eletroinf/displayzao-clock/docs/display_tos_23101.jpg

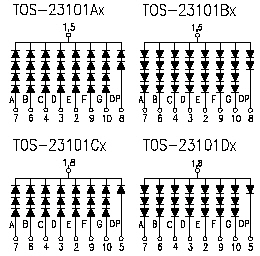
docs/display_tos_23101.jpg
