eletroinf/displayzao-clock/docs/display_tos_23101_.jpg

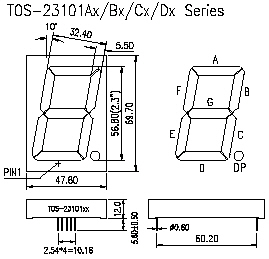
docs/display_tos_23101_.jpg
