eletroinf/displayzao-clock/docs/tos_1106bx.jpg

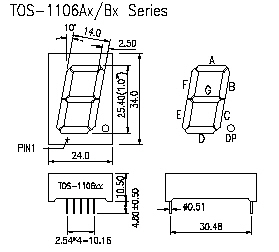
docs/tos_1106bx.jpg
