eletroinf/displayzao-clock/docs/tos_1106bx_.jpg

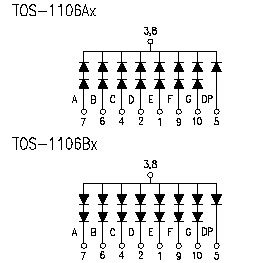
docs/tos_1106bx_.jpg
