eletroinf/displayzao-clock/docs/display_tos_1106.PDF

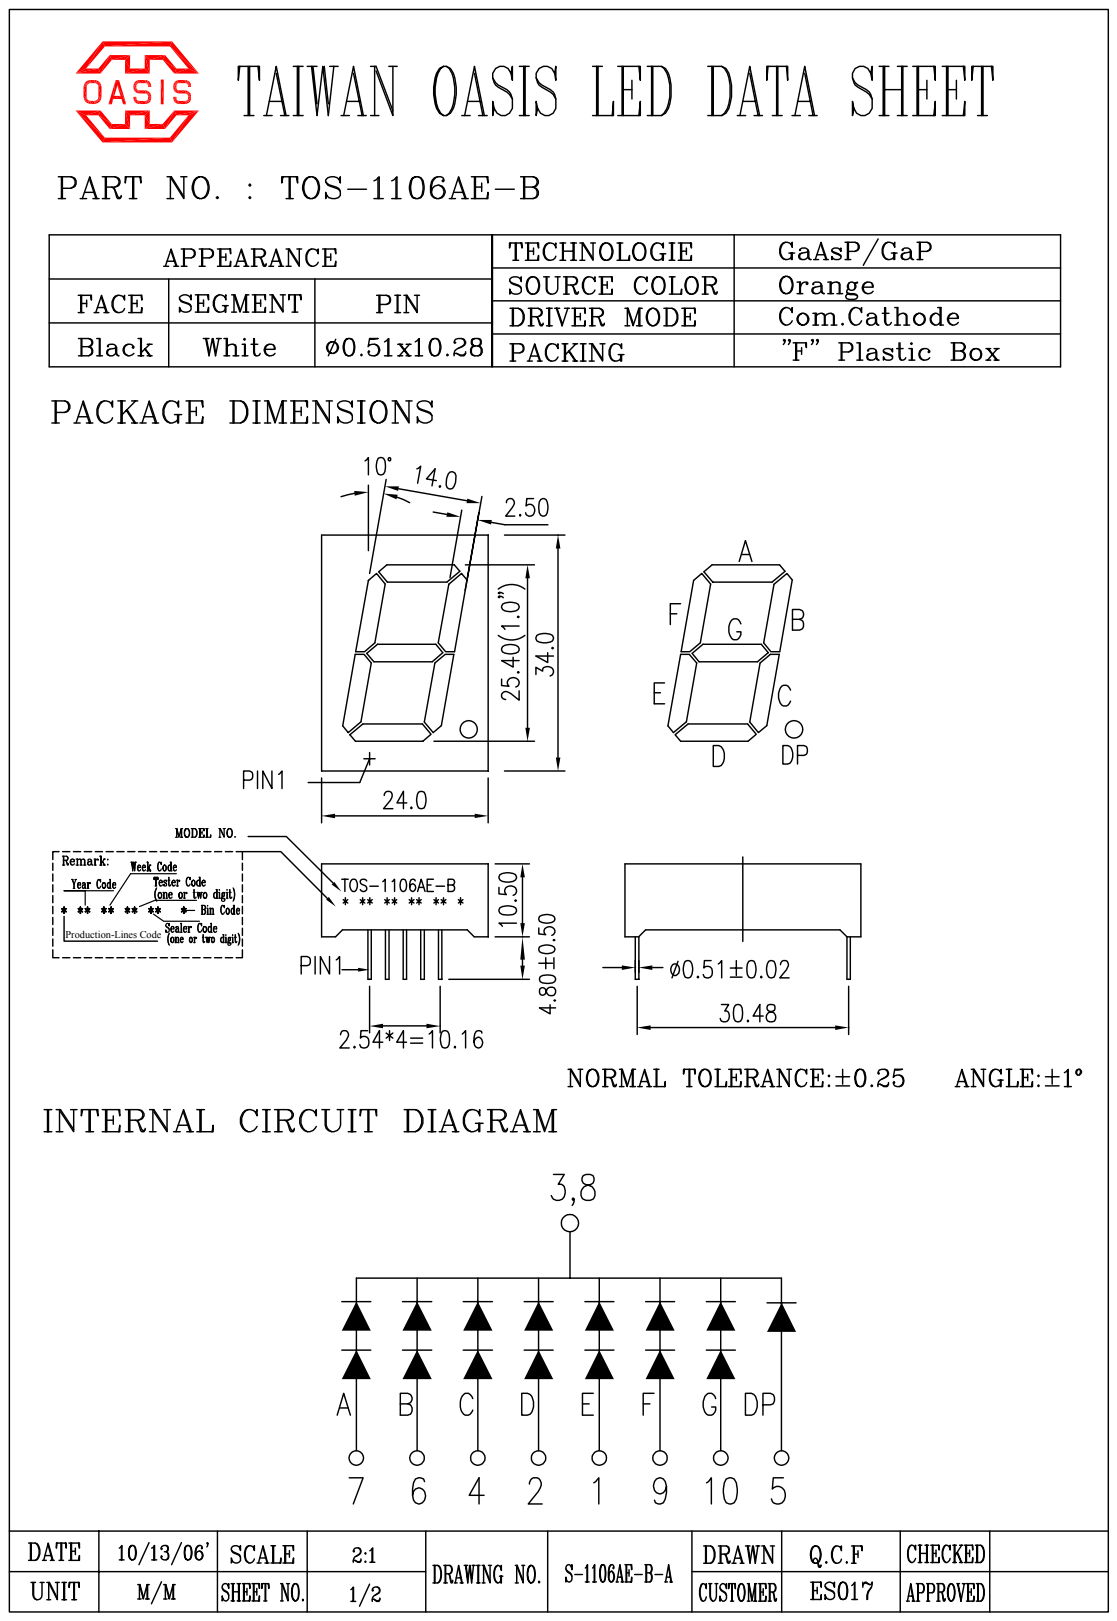
[picture p7: page 1]

Production-Lines Code

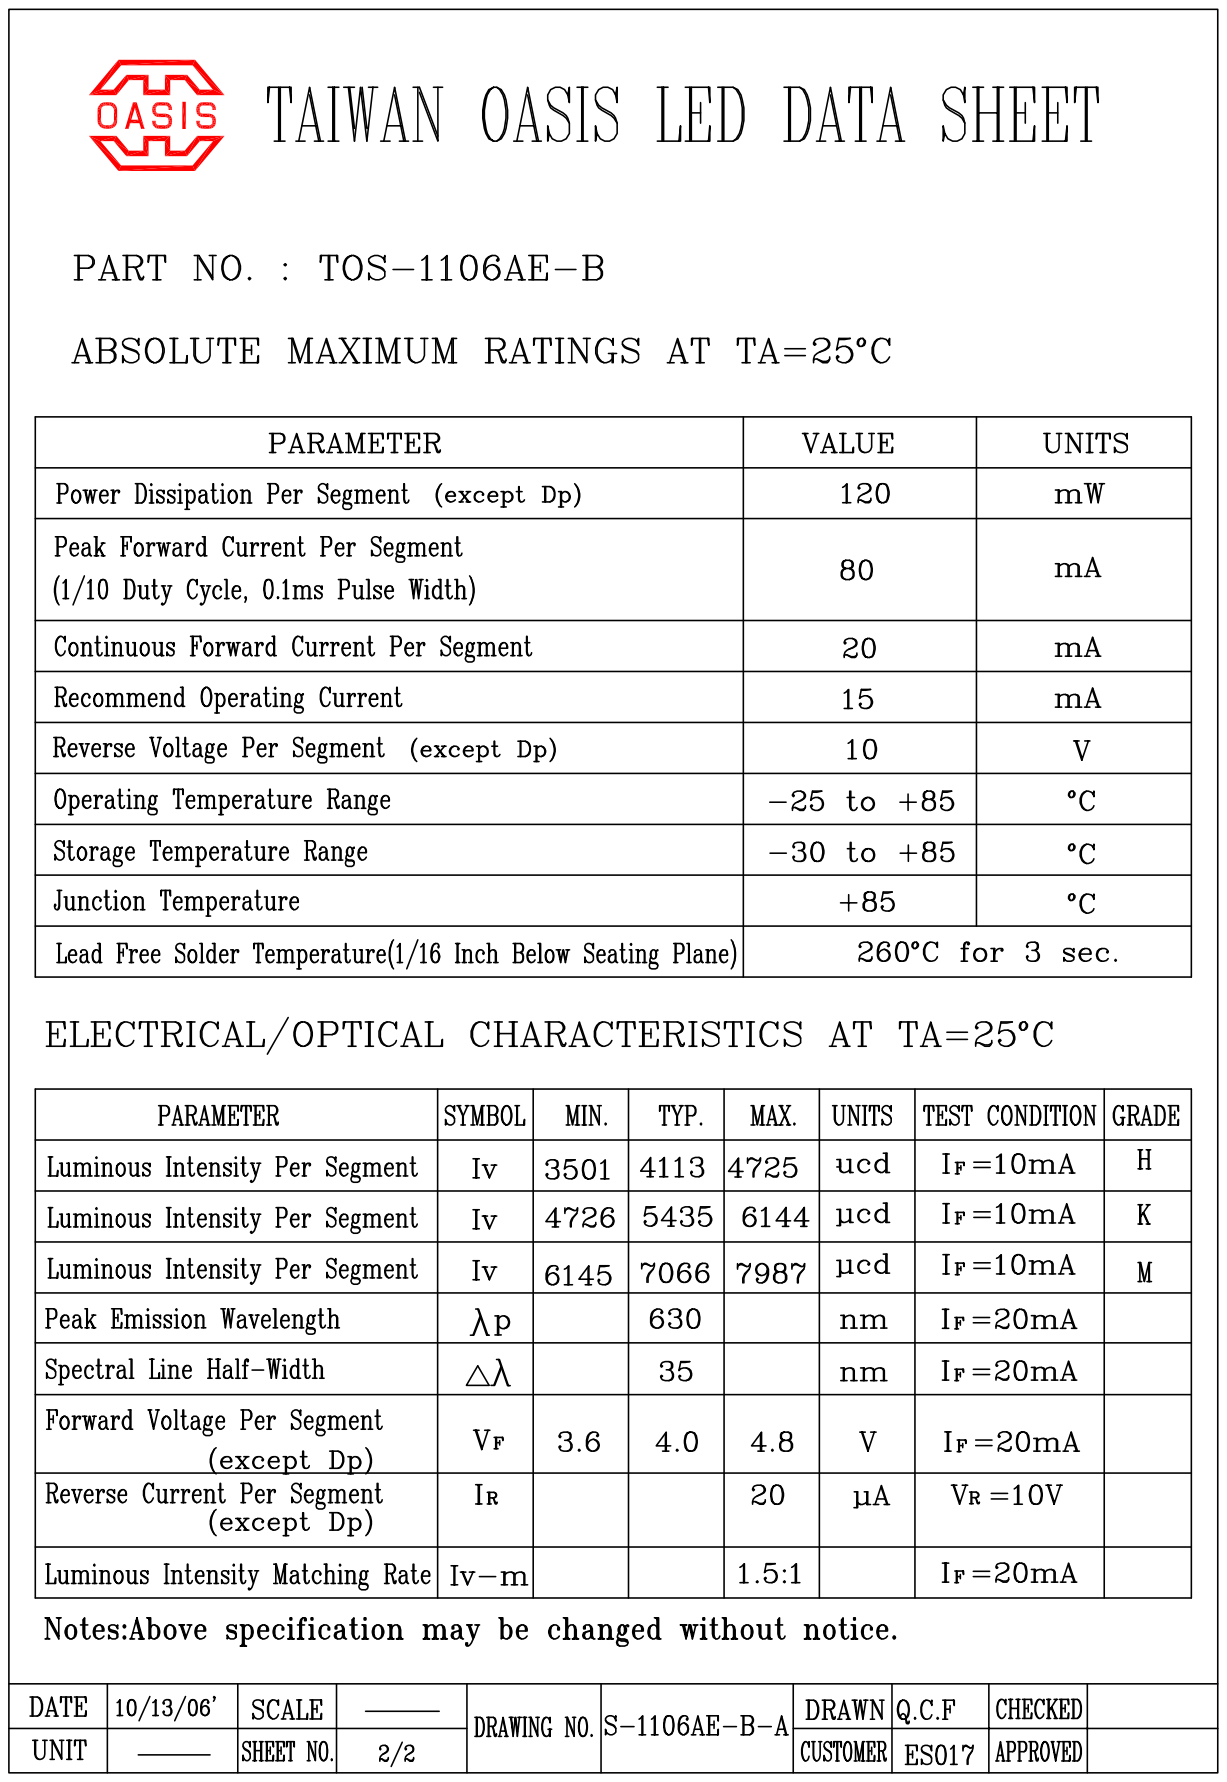
[picture p8: page 2]

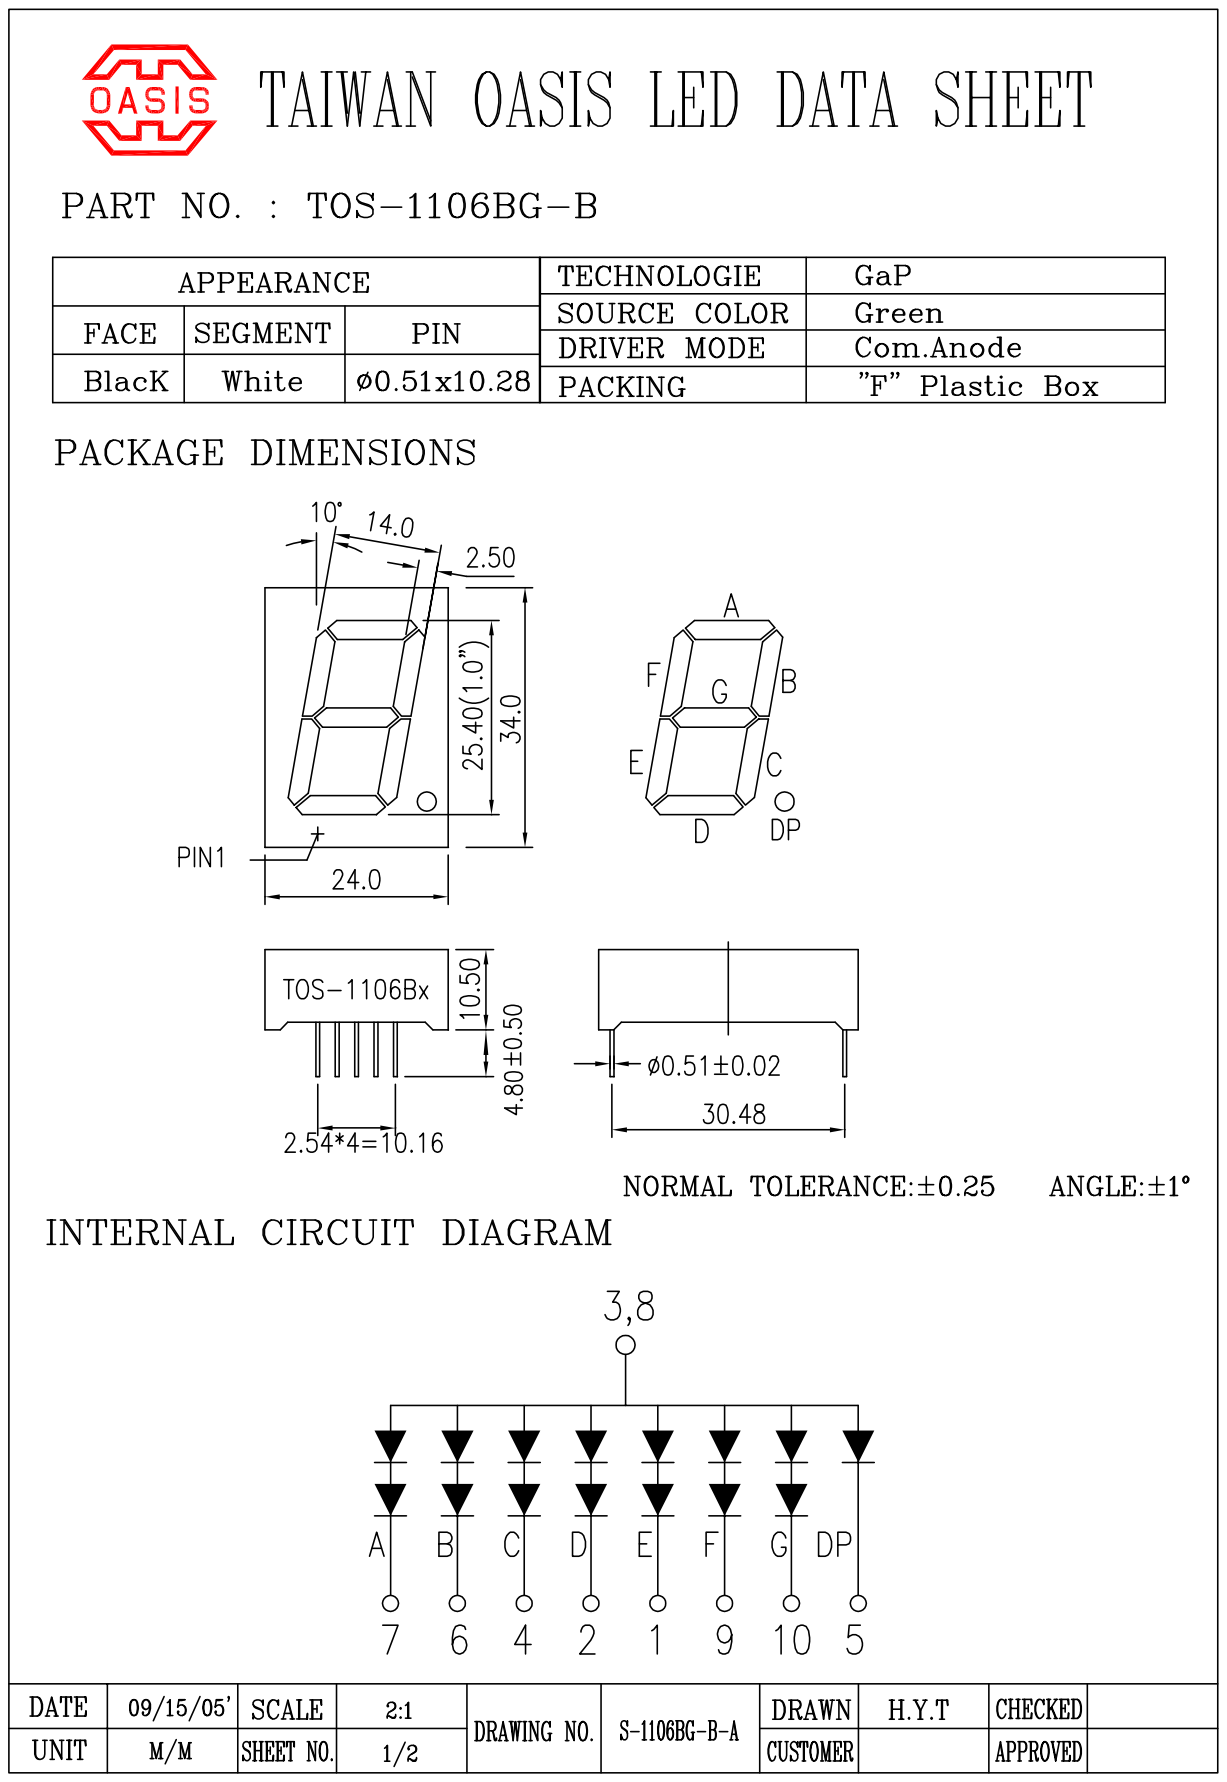
[picture p9: page 3]

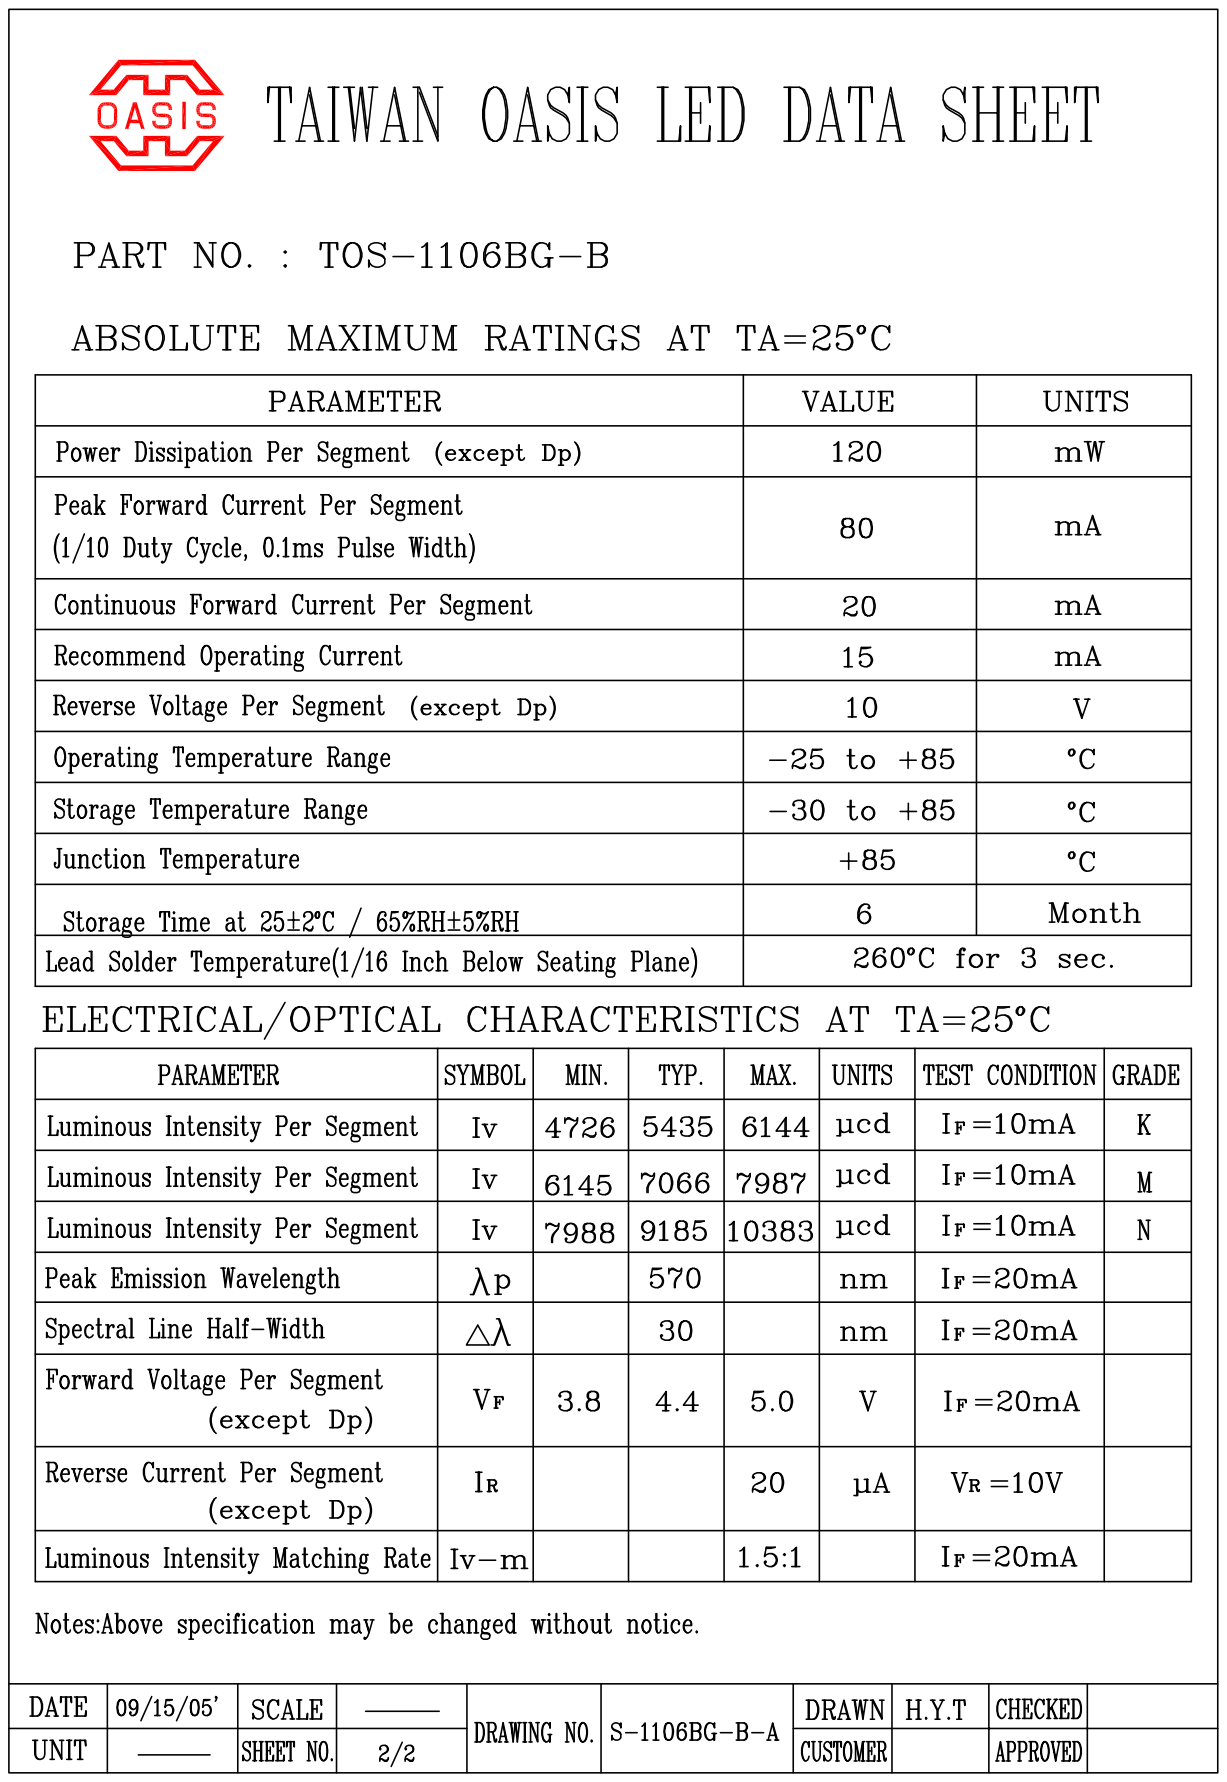
[picture p10: page 4]
