eletroinf/displayzao-clock/(commit log)

2026-09-27 Displayzao: 2007 PIC16F877A LED clock, published as-is
    [relog_displayzao.sch]
2026-09-27 Add MIT license and clarify third-party material
